nivuciis/zbook-rf-shields/zbook-ble-shield-hw/zbook-rf-shields-BLE-P1.pdf

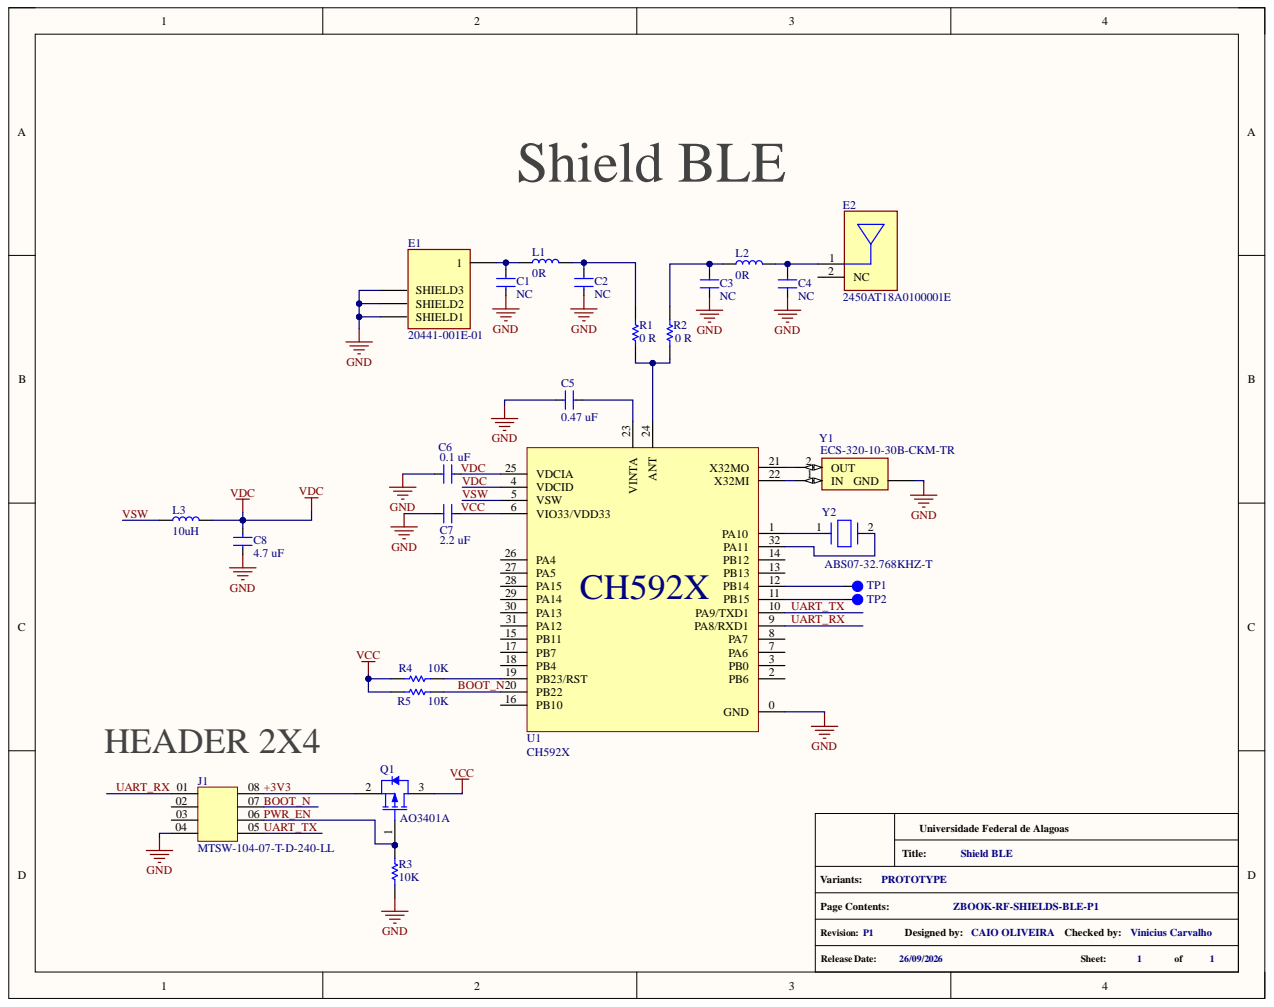
[picture p1: page 1]

Universidade Federal de Alagoas

ZBOOK-RF-SHIELDS-BLE-P1

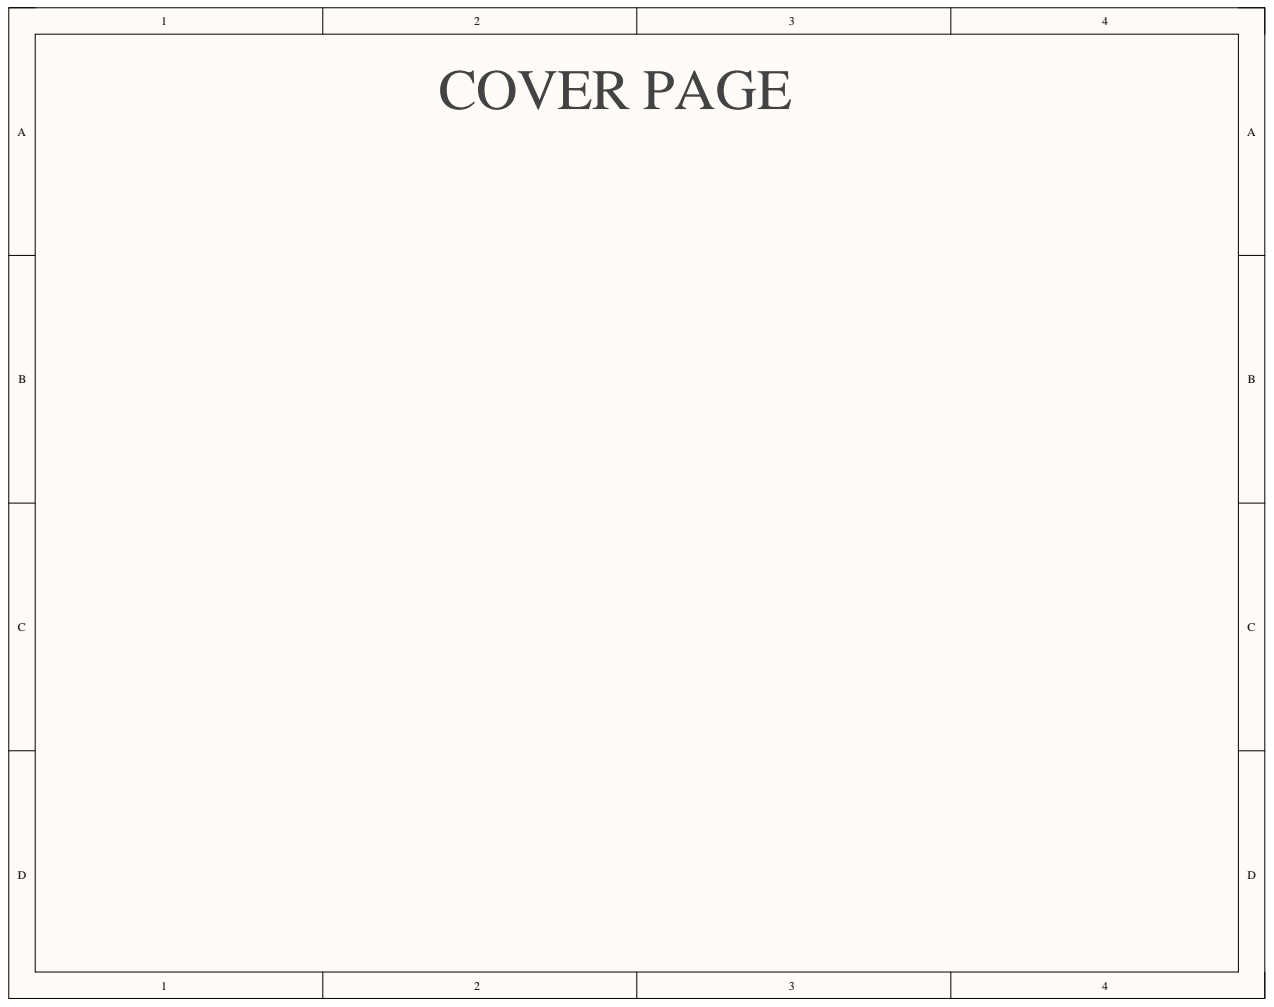
[picture p2: page 2]

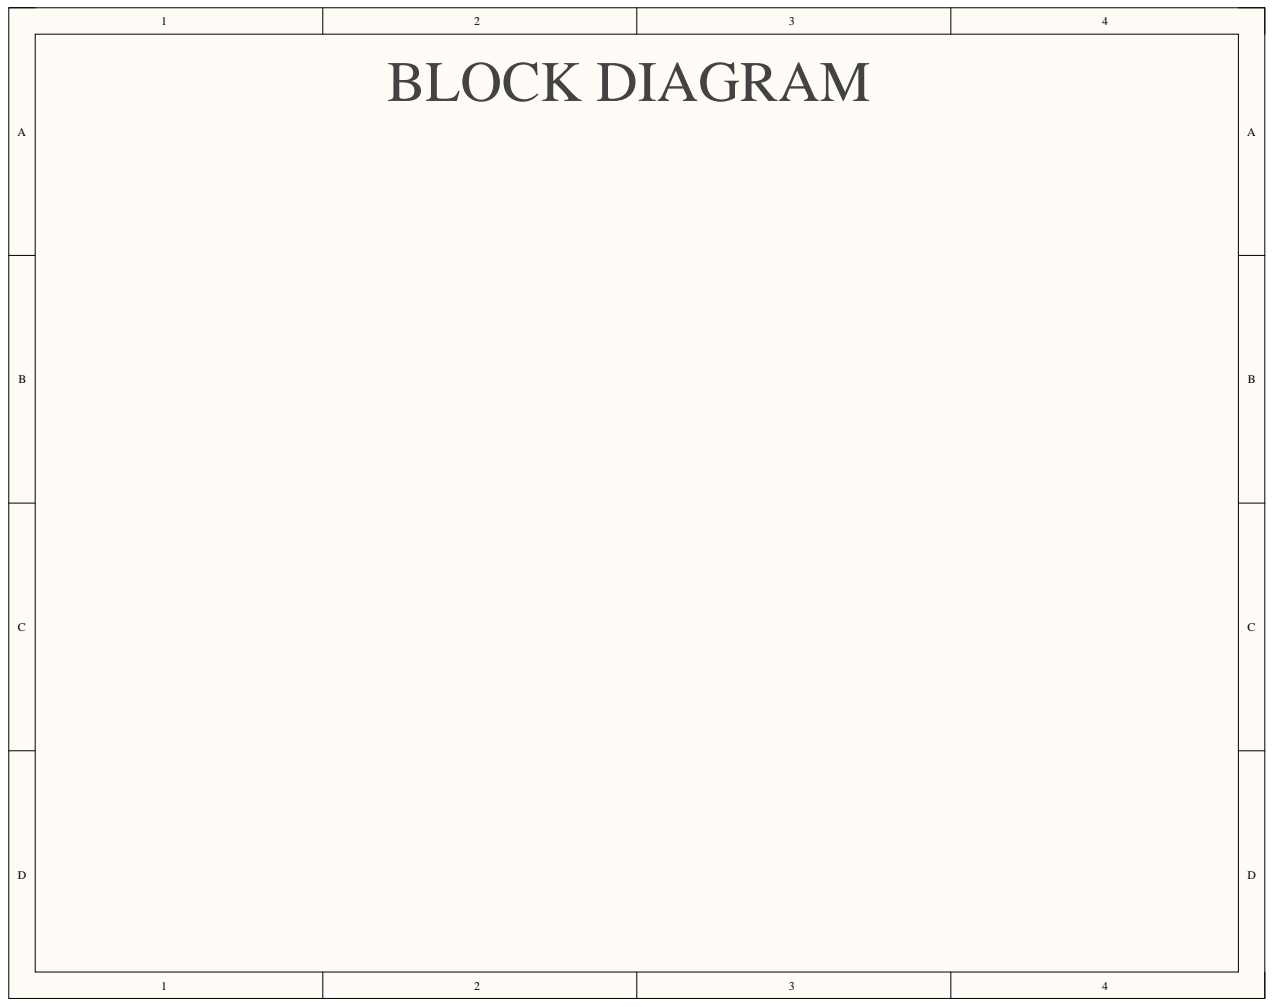
[picture p3: page 3]

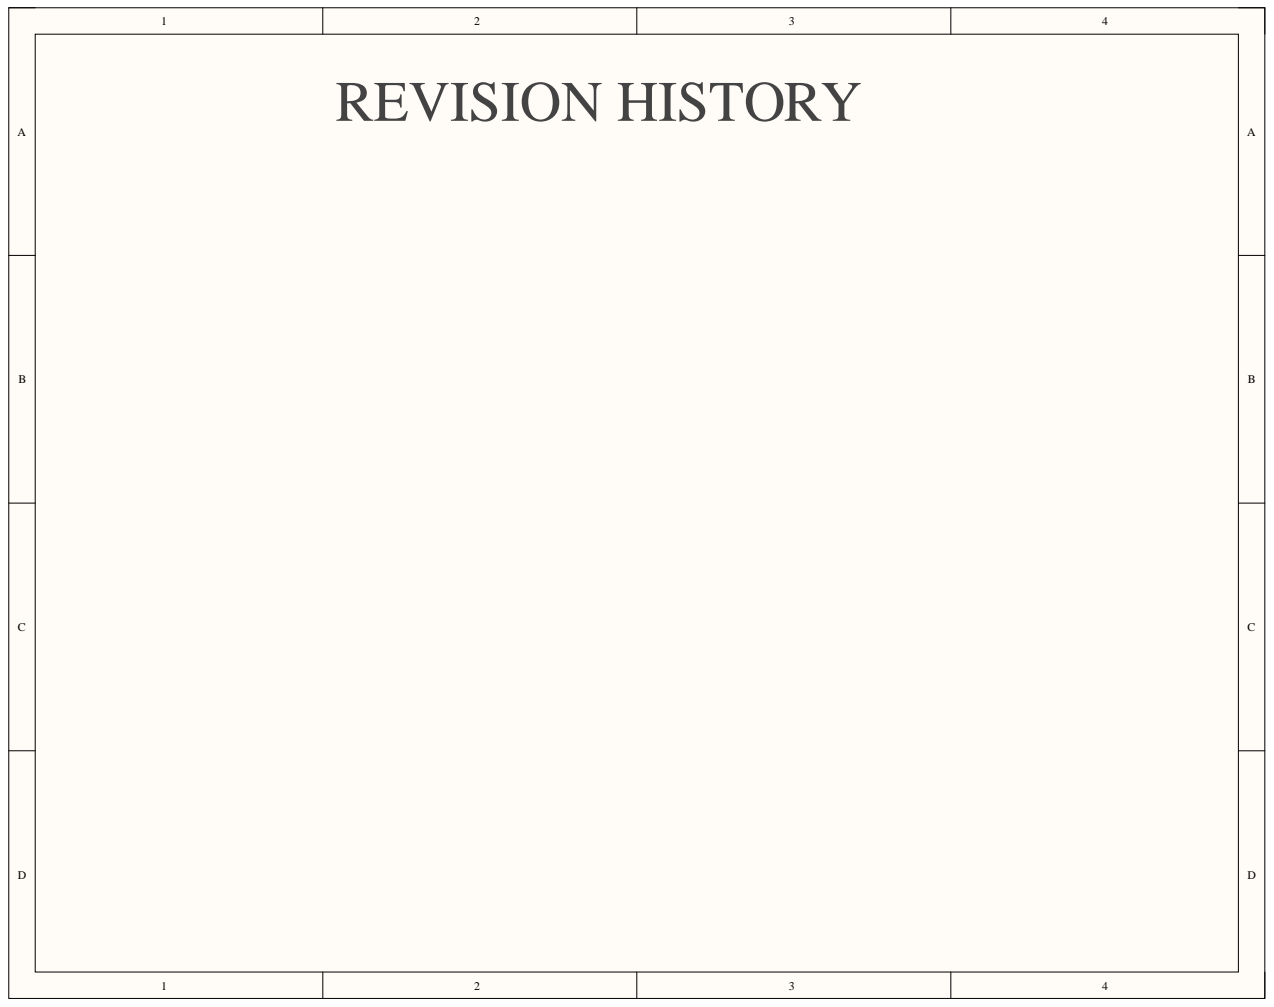
[picture p4: page 4]

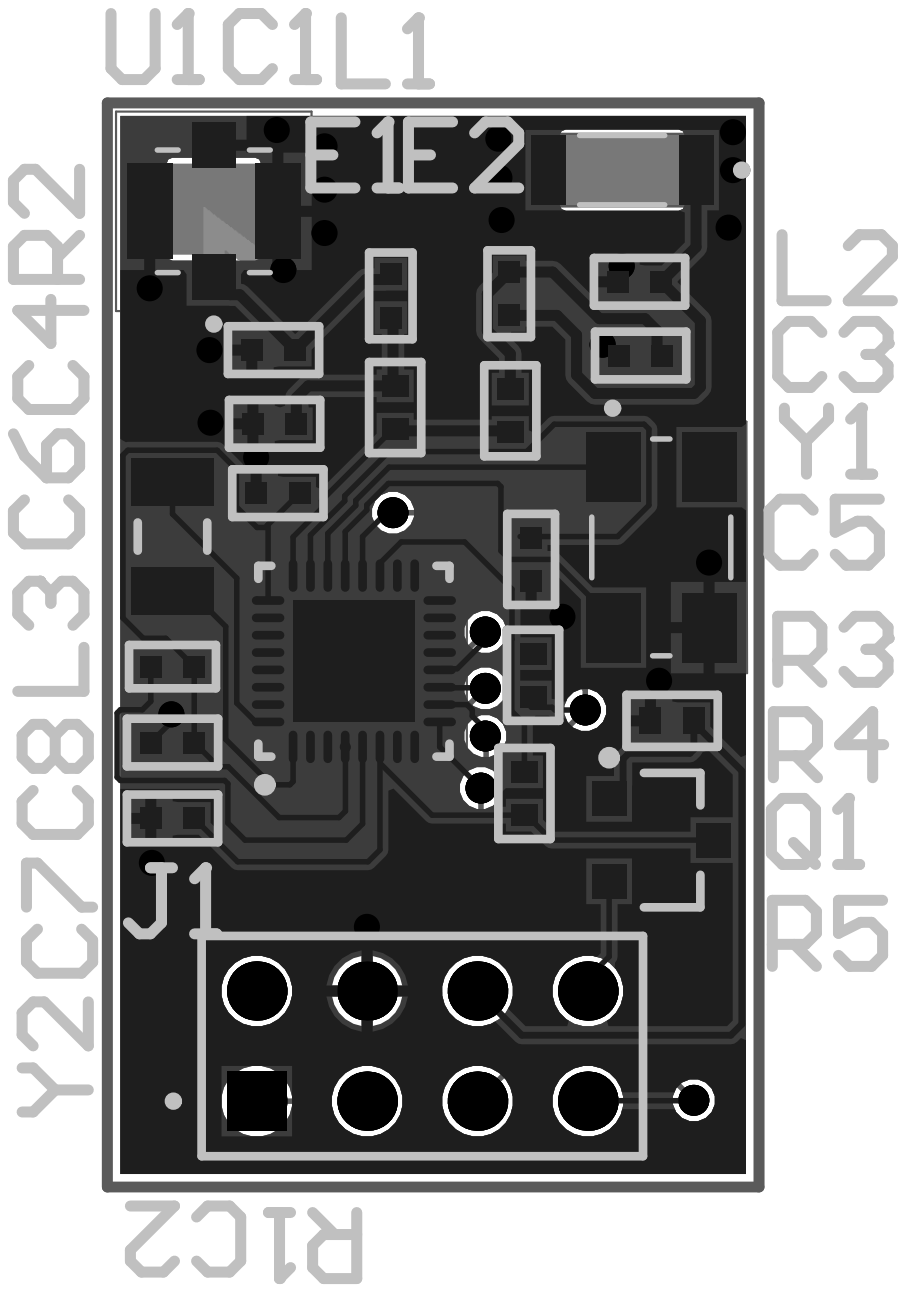
[picture p5: page 5]
