nivuciis/zbook-rf-shields/(list of files, drawings)

Other design files:
zbook-ble-shield-hw/[01] - COVER PAGE.SchDoc
zbook-ble-shield-hw/[02] - BLOCK DIAGRAM.SchDoc
zbook-ble-shield-hw/[03] - BLE MODULE AND CONNECTIONS.SchDoc
zbook-ble-shield-hw/[04] - REVISION HISTORY.SchDoc
zbook-ble-shield-hw/zbook-common-parts.PcbLib
zbook-ble-shield-hw/zbook-rf-shields-BLE-P1.PcbDoc
zbook-ble-shield-hw/zbook-rf-shields-BLE-P1.PcbLib
zbook-ble-shield-hw/zbook-rf-shields-BLE-P1.PrjPcb
zbook-ble-shield-hw/zbook-rf-shields-BLE-P1.SchDoc
zbook-ble-shield-hw/zbook-rf-shields-BLE-P1.SchLib
