nivuciis/zbook-rf-shields/(commit log)

2026-09-17 feat: start schematic design
2026-09-27 Schematic of the CH592X BLE shield for the ZBook
2026-10-12 feat(ble-shield): 4-layer PCB layout and first-review fixes
    Schematic
    - add the missing net labels (VDC, VSW, VCC, PWR_EN, BOOT_N,
    UART_RX, UART_TX, +3V3)
    - link footprints on every component
    - fill Description on all 25 components
    - add .Mounting, .SCHChecked, .PCBChecked, Manufacturer 1 and
    Manufacturer Part Number 1
    - strip the trailing space from those parameter names so ActiveBOM
    resolves them (.BomDoc looks up the unpadded name)
    - fix E1 part number to 20441-001E-01 (I-PEX connector); it carried
    the E2 antenna part number
    - clear the legacy Manufacturer / Manufacturer Part Number duplicates,
    which contradicted the new ones on E1 and E2
    - parameterize the title block instead o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
2026-11-11 feat(rfm95 spi checked): zbook_lora shield + rfm95_spi_check (SPI validated, RegVersion 0x12)
2026-11-12 feat(mesh_scanner): add Meshtastic node scanner and RAK811 test tools
    - apps/mesh_scanner: receive-only Meshtastic node scanner. Drives the RFM95W directly over SPI and polls RegIrqFlags, so DIO0 is not needed. Decodes LongFast packets with the default key (AES-128-CTR) and keeps a node table, with 'mesh' shell commands. 'mesh sync <hex>' enables a raw test mode for non-Meshtastic LoRa.
    - zbook_lora shield: add the lora0 alias.
    - justfile: pass ANSI codes through in the monitor recipe.
2026-11-13 feat(mesh_node): add Meshtastic CLIENT node for the ZBook
    - apps/mesh_node: joins the Meshtastic primary channel (LongFast, default key) as a CLIENT node. Announces NODEINFO, relays packets with managed flooding (SNR-weighted delay, cancelled when another node relays first), sends routing ACKs, answers NODEINFO requests and sends/receives text messages. Tested against a Seeed XIAO ESP32-S3 + Wio-SX1262 running Meshtastic 2.7.26.
    - radio: SX1276 driven over SPI with TX support; DIO0 (IO46) wakes the mesh thread by interrupt, with RegIrqFlags polling as fallback.
    - zbook_lora shield: describe the RFM95W with the semtech,sx1276 binding (RESET on IO01, DIO0 on IO46).
